wisp/wisp5-hw/README.md

WISP 5 - HW
====

Welcome to the WISP5 hardware design file repository!

PDF schematics are available at wisp5.wikispaces.com/WISP+Hardware

The projects and component libraries contained herein will open in the Altium Designer PCB design suite.
