wisp/wisp5-hw/wisp5-bom.xlsx

Designator | DNP | Value | Comment | Description | Footprint | LibRef | Manufacturer | Manufacturer Part Number | Digi-Key Part Number | Quantity
C2 |  | 47uF | Cap | Ceramic Capacitor (Surface Mount) | 0805 | Cap | Samsung Electro-Mechanics | CL21A476MQCLRNC | 1276-2420-1-ND | 1
C3, C8 |  | 0.1uF | Cap | Ceramic Capacitor (Surface Mount) | 0402 | Cap | Murata | GRM155R71C104KA88D | 490-3261-1-ND | 2
C4 |  | 5.6pF | Cap | Ceramic Capacitor (Surface Mount) | 0402 | Cap | Johanson | 500R07S5R6CV4T | 712-1289-1-ND | 1
C5 |  | 10000pF | Cap | Ceramic Capacitor (Surface Mount) | 0402 | Cap | Generic Ceramic Chip Cap (TBD) | CL05B103KP5NNNC | 1276-1502-1-ND | 1
C6, Cp1, Cs1 |  | 33pF | Cap | Ceramic Capacitor (Surface Mount) | 0402 | Cap | Johanson | 500R07S330JV4T | 712-1298-1-ND | 3
C7 |  | 1nF | Cap | Ceramic Capacitor (Surface Mount) | 0402 | Cap | Generic Ceramic Chip Cap (TBD) | GRM1555C1H102JA01D | 490-3244-1-ND | 1
Cp2 |  | 10pF | Cap | Ceramic Capacitor (Surface Mount) | 0402 | Cap | Johanson | 500R07S100JV4T | 712-1253-1-ND | 1
Cs2 |  | 1pF | Cap | Ceramic Capacitor (Surface Mount) | 0402 | Cap | Johanson | 500R07S1R0BV4T | 712-1266-1-ND | 1
D1, D2 |  |  | HSMS-285C | Agilent Schottky Diode, Two in Series, Small Package SOT-323 | SOT-323, HSMS-285C | HSMS-285C | Avago Technologies US Inc. | HSMS-285C-BLKG | 516-2558-ND | 2
D3 |  |  | 2.7V Zener | 1.0 A Surface Mount Schottky Barrier Rectifier, 40 V, -65 to 125 degC, 2-Pin SOD-123 Package, RoHS, Tape and Reel | DIOD-SOD-123-2_V | CMP-0303-00003-1 | ON Semiconductor | MMSZ4682T1G | MMSZ4682T1GOSCT-ND | 1
D4 |  |  | RB751S40T1 | Schottky Diode | SOD-523 | RB751S40T1 | ON Semiconductor | RB751S40T1G | RB751S40T1GOSCT-ND | 1
L1 |  | 16nH | Ind | Inductor (Surface Mount) | 0603 | Ind | Coilcraft (http://www.coilcraft.com/0402cs.cfm) | 0402CS-16NX_LU | N/A | 1
LED1, LED2 |  |  | LED | Typical RED, GREEN, YELLOW, AMBER GaAs LED | Diode - 0603 | Diode - LED | OSRAM | LS L29K-G1J2-1-Z | 475-2506-1-ND | 2
Q1 |  |  | BF1101WR | N-Channel Dual-Gate Mos-Fets MOSFET, SOT343R | SOT343R | BF1101WR | NXP Semiconductors | BF1101WR,115 | 568-6140-1-ND | 1
R1 |  | 560k | Res | Chip Resistor (Surface Mount) | 0402 | Res | Panasonic | ERJ-2RKF5603X | P560KLCT-ND | 1
R2 |  | 22k | Res | Chip Resistor (Surface Mount) | 0402 | Res | Panasonic | ERJ-2RKF2202X | P22.0KLCT-ND | 1
R3 |  | 220k | Res | Chip Resistor (Surface Mount) | 0402 | Res | Panasonic | ERJ-2RKF2203X | P220KLCT-ND | 1
R4, R5 |  | 33 | Res | Chip Resistor (Surface Mount) | 0402 | Res | Panasonic | ERJ-2RKF33R0X | P33.0LCT-ND | 2
R6, R8 |  | 47k | Res | Chip Resistor (Surface Mount) | 0402 | Res | Panasonic | ERJ-2RKF4702X | P47.0KLCT-ND | 2
R7, R9, R10 |  | 100k | Res | Chip Resistor (Surface Mount) | 0402 | Res | Panasonic | ERJ-2RKF1003X | P100KLCT-ND | 3
SBW1 |  |  | 4-Pin 0.05" Pitch Female Rt Angle Header | Header, 4-Pin | MHDR1X4 | MHDR1X4 | Mill-Max Manufacturing | 851-43-004-20-001000 | ED90474-ND | 1
U1 |  | 2.4v | S-882Z24 | ULTRA-LOW VOLTAGE OPERATION CHARGE PUMP IC FOR STEP-UP DC-DC CONVERTER STARTUP | SOT23-5 | S-882Zxx | Seiko Instruments | S-882Z24-M5T1G | S-882Z24-M5T1G-ND | 1
U2 |  |  | TPS780330220DDCR | Single Output LDO, 150 mA, Adjustable 1.22 to 5.25 V Output, 2.2 to 5.5 V Input, with 500 nA Quiescent Current, 5-pin SOT (DDC), -40 to 125 degC, Green (RoHS & no Sb/Br) | TI-DDC5_L | CMP-0394-01119-1 | Texas Instruments | TPS780330220DDCR | 296-23332-1-ND | 1
U3 |  |  | Comparator | Comparator: On Semi 10uA Comparator | SC70-5 | NCS2200 | ON Semiconductor | NCS2200SQ2T2G | NCS2200SQ2T2GOSCT-ND | 1
U4 |  |  | MSP430 Wolverine 48-Pin | 16-bit FRAM MCU | MSP_QFN48_RGZ_PAD0 | MSP430FR596X_586X_RGZ | Texas Instruments | MSP430FR5969IRGZR | 296-37875-1-ND | 1
U5 |  |  | ADXL362 | Analog Devices low power accelerometer | ADXL362 | ADXL362 | Analog Devices | ADXL362BCCZ-RL7 | ADXL362BCCZ-RL7CT-ND | 1
U6 |  |  | SI1016X | NMOS and PMOS array | SC-89-6 Vishay | SI1016X | Vishay Siliconix | SI1016X-T1-GE3 | SI1016X-T1-GE3CT-ND | 1
Y1 |  | 32.768kHz | XTAL | Crystal Oscillator - [3.20mm x 1.50mm] | XTAL [3.20mm x 1.50mm] | XTAL 2-pins | Epson Toyocom Corporation | FC-135 32.7680KA-A3 | SE2413CT-ND | 1
C1 | DNP | DNP | Cap | Ceramic Capacitor (Surface Mount) | 0805 | Cap |  |  |  | 1
C9 | DNP | DNP | Cap | Ceramic Capacitor (Surface Mount) | 0402 | Cap |  |  |  | 1
P1 | DNP |  | MHDR1X8 | Header, 8-Pin | MHDR1X8 | MHDR1X8 |  |  |  | 1
P2 | DNP |  | MHDR1X3 | Header, 3-Pin | MHDR1X3 | MHDR1X3 |  |  |  | 1
SMA1 | DNP |  | SMA - Hole - 2 Pin | Two pin SMA connector wisp | SMA - Hole - 2 Pin | SMA - Hole - 2 Pin |  |  |  | 1
TxRx | DNP |  | MHDR1X2 | Header, 2-Pin | MHDR1X2 | MHDR1X2 |  |  |  | 1
