wisp/wisp5-hw/(list of files, drawings)

Other design files:
wisp5-lrg/wisp5-form-factor-dipole.PcbDoc
wisp5-lrg/wisp-5-0.PrjPcb
wisp5-lrg/wisp-5-afe.SchDoc
wisp5-lrg/wisp-5-main.SchDoc
wisp5-lrg/wisp-5-mcu.SchDoc
wisp5-lrg/wisp-5-peripherals.SchDoc
