wisp/wisp5-hw/(threads)

Thread 2 (2015-05-08):

we can not get S-882Z.....

maxever, 2015-05-08:
Hello guys.  I am a student from UESTC, China,and I am very interest in WISP5. In China ,we can't get the S-882Z, is there any other device can  replace it？

anparks, 2015-05-11:
Hi maxever,

Great question! In fact, the Seiko S-882Z was recently discontinued and is not available anywhere! This is obviously a problem for those hoping to build their own WISP5-LRG. There is no direct replacement part available for this sort of highly sensitive DC-DC charge pump... we've exhaustively searched as of several months ago.

You have at least three options:

1. Request preassembled WISP5-LRG devices from us (no charge for academic collaborators) at mailwisp@gmail.com. There is typically a limit of three devices per lab or project.

2. You can wait until we have open sourced the design for the WISP5-HPW, which does not make use of the Seiko S-882Z. It will instead make use of a classic RF Dickson charge pump with discrete diodes... see the old WISP4.1 design files for an example of what the classic RF Dickson charge pump will look like.

3. You can attempt to modify the design to make use of the BQ25570, an inductive charge management IC we've found to be almost as effective as the S-882Z but which requires a very different topology. See our paper "WISPCam: A Battery-Free RFID Camera" (http://ben.ransford.org/papers/rfid15-wispcam.pdf) in which our design makes use of the BQ25570.

csqjxiao, 2016-10-09:
Hi, Anparks:

I am a researcher coming from the Southeast University of China, and quite interested in projects about the energy harvesting WISP5 tags. I wonder whether the WISP5 HPW tags are ready for purchase right now. I saw on the following Q&A page, showing that the 3-stage Dickson charge pump (with external voltage supervisory ICs) may have better harvesting performance than the 1-stage Seiko S-882Z.
http://wisp5.wikispaces.com/share/view/73650110

Thanks for your kind help.

Qingjun Xiao

anparks, 2016-10-13:
Hi Qingjun,

No, the reason we went with the S-882Z is that it does in fact have better range performance than the N-stage discrete diode charge pump. The discrete charge pump performs more efficiently at higher power levels (short range).

We have not completed the WISP5-HPW yet; we haven't actually seen much interest in it.

In other news, we have "heard rumors" that the S-882Z or a similar pin-compatible product from Seiko IC might become available again soon.

Best regards,
Aaron

alexeicolin, 2018-04-19:
Would this one work? [S-8823A](https://www.ablicinc.com/en/semicon/datasheets/power-management-ic/charge-pump-ic/s-8823a/). Appears to have the same pinout as S-882Z.

The 2.2V version is in stock at [chip1stop.com in Japan](https://www.chip1stop.com/web/USA/en/search.do?classCd=&did=&keyword=S-8823A22-M5T1U&categolySortFlag=1). I sent a request for quote for the 2.4V version.

TheaperDeng, 2018-10-18:
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

So, how did you solve this problem? (Can't get S-882Z)

SAKURA1998, 2018-10-20:
>           Hello guys.  I am a student from UESTC, China,and I am very interest in WISP5. In China ,we can't get the S-882Z, is there any other device can  replace it？
Did you manage to get this component, or some other method to get this WISP-LRG?

anparks, 2018-10-23:
Sure, as far as I know you can use the S-8823A24. If I remember correctly, the two have slightly different standby mode current consumption, with the 8880A slightly lower, but other than that they appear to be identical:

https://www.ablic.com/en/semicon/products/power-management-ic/charge-pump-ic/

Pongoid, 2021-09-11:
Any luck sourcing replacements for the Seiko/ABLIC parts since they appear to have discontinued all of their ultra low voltage charge pumps? I'd rather not use any inductors or transformers if at all possible.

Thank you in advance.

Thread 3 (2016-07-28):

Decoupling caps are too large

anparks, 2016-07-28:
The MSP430 decoupling capacitor C8 is far too large at 4.7uF, needs to be reduced down to 470nF or less. We've tested successfully at 100nF.

Also check other supply decoupling capacitors.

The problem occurs when the Seiko or other charge manager switches on a path from the reservoir to the load, at which point the load decaps charge. This inrush current, especially in the case of high ESR in the Seiko, causes a voltage sag which can black out the system.

anparks, 2017-01-09:
Resolved

Closed 2017-01-09.

Thread 4 (2018-11-29):

0402CS-16NX_LU footprint conflict

TheaperDeng, 2018-11-29:
I’m working on make a sample of Wisp5 and I found a problem.

On the bom table, L1 has its Manufacturer Part Number as 0402CS-16NX_LU, which is 0402 packaging. And on the PCB board file, it has footprint as 0603. How should I solve this conflict?

anparks, 2018-11-29:
Hi TheaperDeng,

Good catch.

Sometimes larger footprints are used to allow easier hand soldering/rework, or to allow either size (0603 or 0402) parts to be populated. It is very likely that the 0402 device can be populated on the slightly larger 0603 footprint without any issues. You can contact your PCB assembler to confirm that they will not have an issue with this.

Best luck,
Aaron

Closed 2018-11-29.

Thread 5 (2019-03-12):

How to match the impedance while Wisp cannot harvest energy

donghuixin, 2019-03-12:

hustYangHang, 2019-03-12:
Measure the impedance of antenna with the sma hole on board,then calc and select capicity and Inductor

donghuixin, 2019-03-19:
Problem solved,thanks

Closed 2019-03-19.

Thread 6 (2020-01-23):

The schematic Link is not available

devararendy, 2020-01-23:
Hi glad to see this project.

but unfortunately I couldn't open the schematic webpage on wikispace.
Could you reupload the schematic ?

manucirne, 2020-12-23:
Super glad with the project!
But I have the same problem.

decoejz, 2021-02-23:
Hi, I am having the same problem to access the documentation.
