wisp/wisp5-hw/(commit log)

2014-10-07 Initial commit. Added first run wisp5-lrg design files.
    [wisp-5-0.PrjPcb, wisp-5-afe.SchDoc, wisp-5-main.SchDoc, wisp-5-mcu.SchDoc, wisp-5-peripherals.SchDoc, wisp5-bom.xlsx, wisp5-form-factor-dipole.PcbDoc]
2015-04-29 Added TX and RX breakout pins. Also the tuning values changed.
    [wisp-5-0.PrjPcb, wisp-5-mcu.SchDoc, wisp5-bom.xlsx, wisp5-form-factor-dipole.PcbDoc]
2017-01-07 Updated part numbers in schematic view, for better BOMs.
    [wisp-5-0.PrjPcb, wisp-5-afe.SchDoc, wisp-5-main.SchDoc, wisp-5-mcu.SchDoc, wisp-5-peripherals.SchDoc, wisp5-form-factor-dipole.PcbDoc]
2017-01-09 Exported new BOM.
    [wisp-5-0.PrjPcb, wisp5-bom.xlsx]
2017-01-09 Reduced decoupling caps on VREG to address issue #3
    [wisp-5-0.PrjPcb, wisp-5-afe.SchDoc, wisp-5-mcu.SchDoc, wisp5-bom.xlsx]
2017-06-16 Updated tuning match values based on latest tuning results
    [wisp-5-0.PrjPcb, wisp-5-afe.SchDoc]
